JulienGlld/Cocktailec/Presentation finale.pptx

## COCKTAILEC

Julien GUILLAUD & Rayane EL KHANOUSSI

## Sommaire

- Introduction
1. Rappel des objectifs initiaux
2. Matériel utilisé
3. Schéma du fonctionnement du projet
4. Algorithme
5. Problèmes rencontrés et solutions trouvées
- Conclusion

## Introduction

Pourquoi avoir choisi ce sujet ?
- Utile dans la vie de tous les jours
- Simplifie la vie
- Concept ludique
- Echec dans ce projet l’an dernier

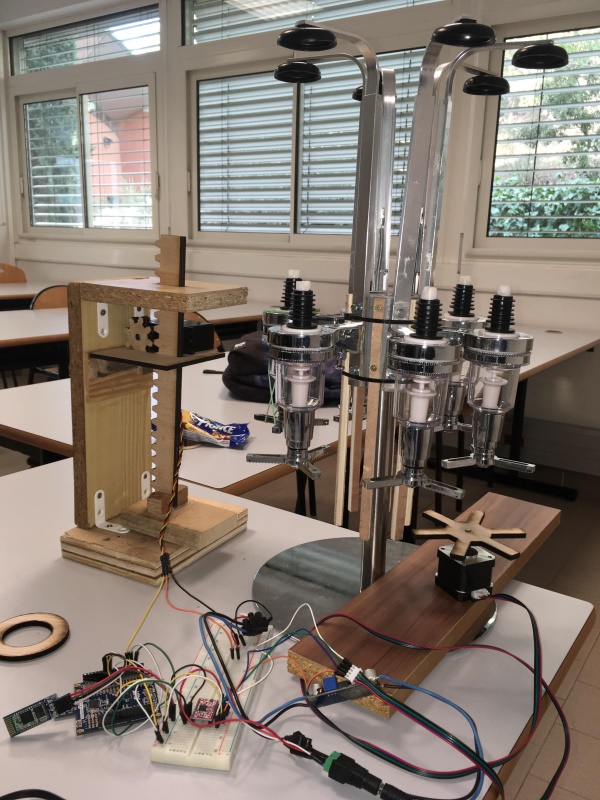
[picture p1: figure]

## 1. Rappel des objectifs initiaux

- Bar piloté par un smartphone avec une liaison Bluetooth
- Deux « stands » :
  - Stand liquide, pour les sirops et l’eau
  - Stand solide, pour la menthe ou les glaçons
- Le stand liquide est un distributeur de boissons qui doit supporter six bouteilles disposées de façon circulaire. Un moteur pas à pas permet la rotation des bouteilles
- La structure du second stand sera composée de plusieurs tubes de PVC contenant différents solides et dont le versement s’effectuera grâce à un système de vis sans fin.
- Pour passer d’un stand à l’autre, le verre sera disposé sur un rail qui avancera grâce à un moteur pas à pas.
- Deux couleurs de LED :
  - Une rouge lorsque le cocktail sera en cours de préparation
  - Une verte lorsque celui-ci sera terminé

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
## 1. Rappel des objectifs initiaux

- Nos « vrais » objectifs :
  - Faire tourner le stand de bouteilles
  - Appuyer sur le verseur
  - Commande Bluetooth
  - Coordonner le tout

## 2. Matériel utilisé

- Carte Arduino & PC
- Téléphone Android & Bluetooth Electronics®
- Module Bluetooth
- Un moteur pas à pas
Un servomoteur HB-805BB⁺
Découpeuse laser
Scie oscillante
Distributeur de boisson

## 2. Matériel utilisé

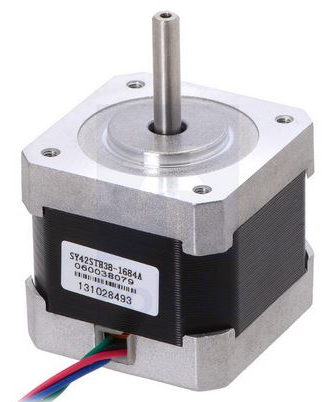
[picture p2: figure]

## 2. Matériel utilisé

- Carte Arduino & PC
- Téléphone Android & Bluetooth Electronics®
- Module Bluetooth
- Un moteur pas à pas
- Un servomoteur HB-805BB⁺
Découpeuse laser
Scie oscillante
Distributeur de boisson

## 2. Matériel utilisé

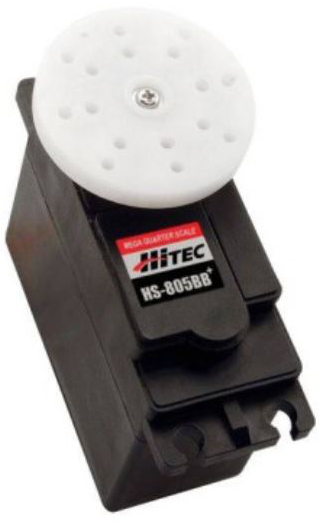
[picture p3: figure]

## 2. Matériel utilisé

- Carte Arduino & PC
- Téléphone Android & Bluetooth Electronics®
- Module Bluetooth
- Un moteur pas à pas
- Un servomoteur HB-805BB⁺
- Découpeuse laser
Scie oscillante
Distributeur de boisson

## 2. Matériel utilisé

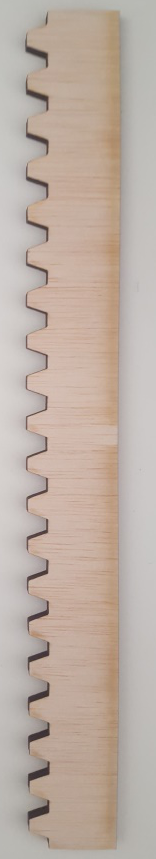
[picture p4: figure]
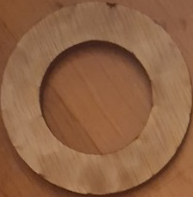
[picture p5: figure]
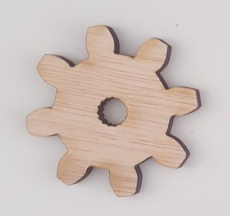
[picture p6: figure]
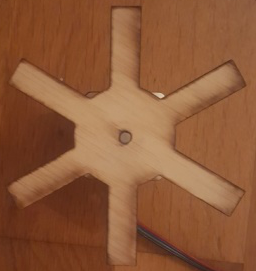
[picture p7: figure]

## 2. Matériel utilisé

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

## 2. Matériel utilisé

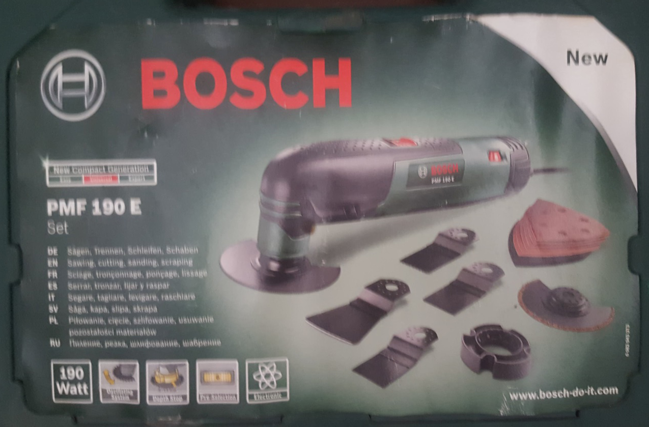
[picture p8: figure]

## 2. Matériel utilisé

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

## 2. Matériel utilisé

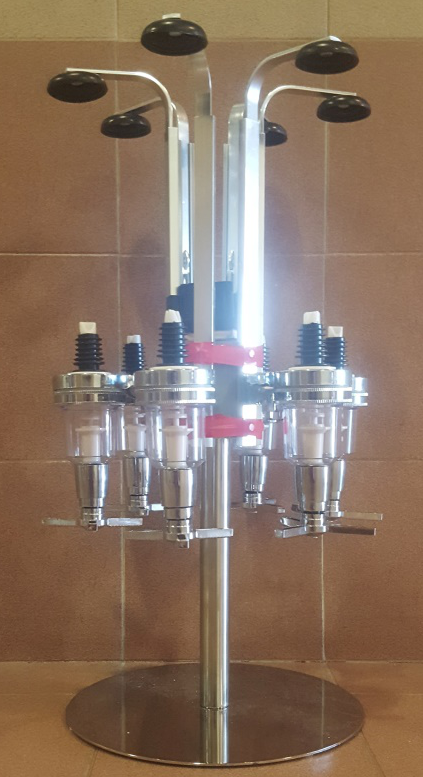
[picture p9: figure]

## 3. Schéma de fonctionnement

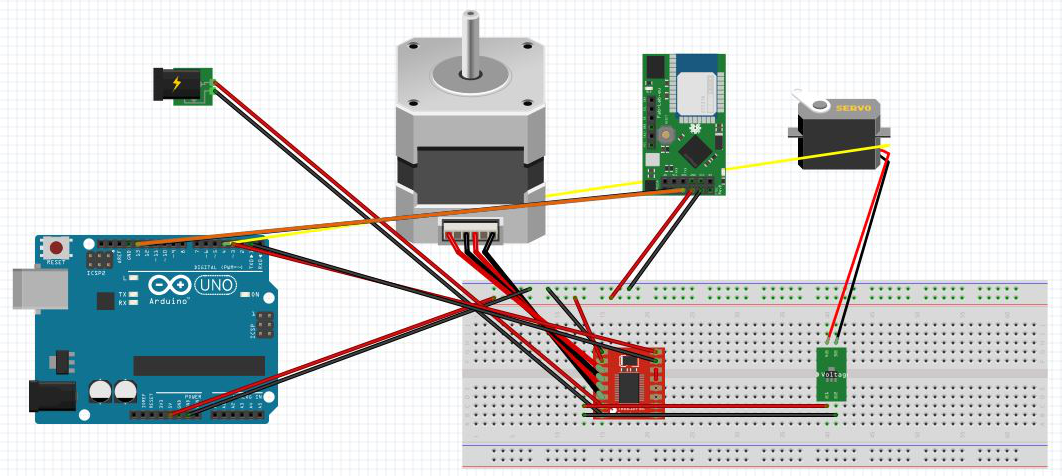
[picture p10: figure]

## Slide 17

## 4. Algorithme

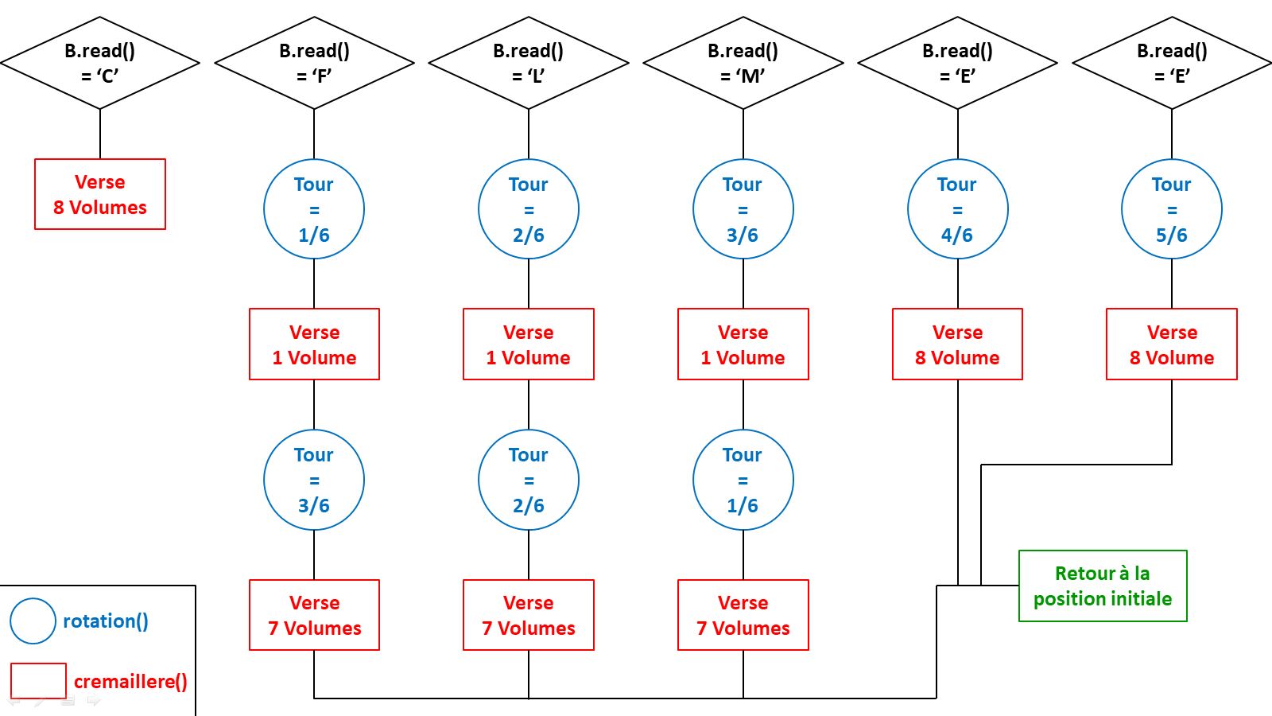
[picture p11: figure]

## Slide 19

B.read() = ‘C’

Verse
8 Volumes

B.read() = ‘F’

B.read() = ‘L’

B.read() = ‘M’

B.read() = ‘E’

B.read() = ‘E’

Tour = 1/6

Tour = 2/6

Tour = 3/6

Tour = 4/6

Verse
8 Volume

Tour = 5/6

Verse
8 Volume

Verse
1 Volume

Tour = 3/6

Verse
7 Volumes

Verse
1 Volume

Tour = 2/6

Verse
7 Volumes

Verse
1 Volume

Tour = 1/6

Verse
7 Volumes

Retour à la position initiale

rotation()

cremaillere()

## 5. Problèmes rencontrés et solutions trouvées

- Comment faire tourner le stand de bouteilles ?
  1. Agrandir le cylindre central afin de poser le moteur par-dessus.
  2. Faire tourner le stand par le bas grâce à des tiges en bois vissées dans le cylindre, et entrainées par un engrenage fixé au moteur.

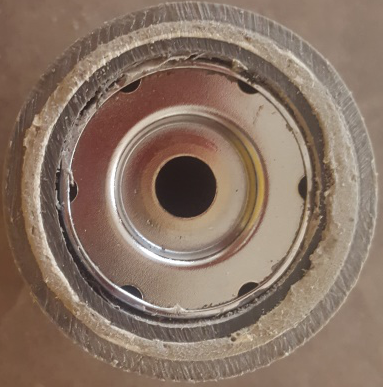
[picture p12: figure]
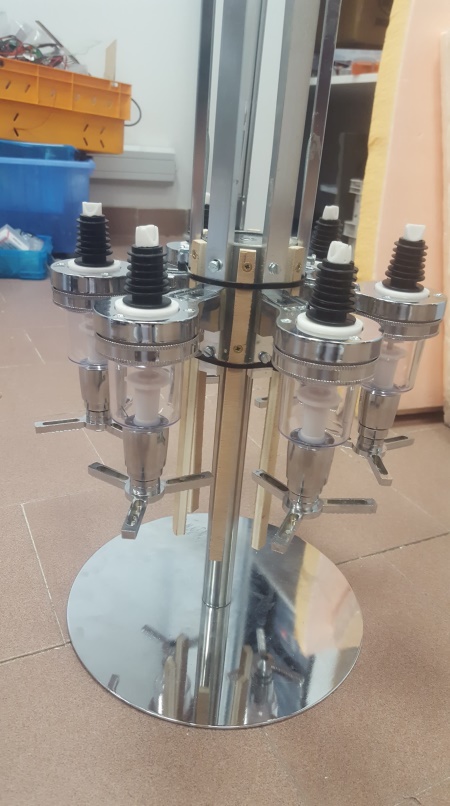
[picture p13: figure]
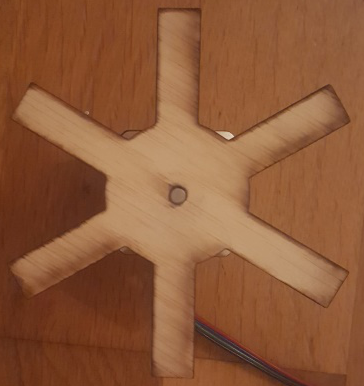
[picture p14: figure]

## 5. Problèmes rencontrés et solutions trouvées

- Comment appuyer sur le verseur de liquide ?
  1. Utilisation d’un servomoteur HS-805BB⁺
  2. Création d’une crémaillère entrainée par un pignon fixé sur le servomoteur

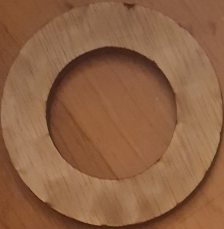
[picture p15: figure]
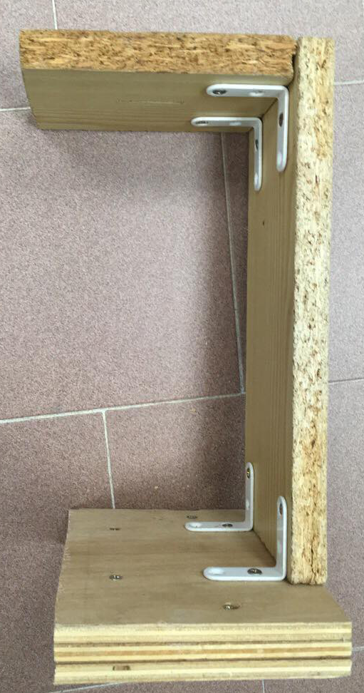
[picture p16: figure]
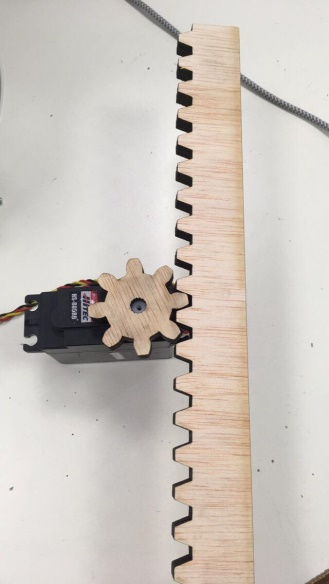
[picture p17: figure]

## Conclusion

- Projet très intéressant
- Travail en autonomie
- Beaucoup de travail en dehors des séances
- Pas assez de temps
- Perspectives futures
