JulienGlld/Cocktailec/Repartition des taches.jpg

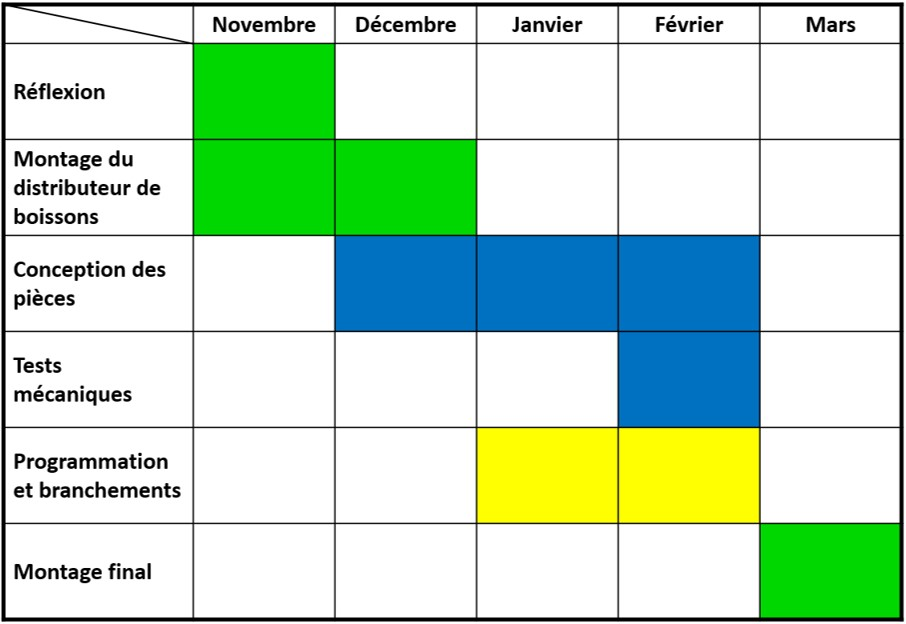
Repartition des taches.jpg
